kb3gtn/FT2232_JTAG/README.md

# FT2232_JTAG
 FT2232 JTAG/SPI/UART/GPIO board
