kb3gtn/FT2232_JTAG/FT2232_Board.xlsx

item | Description | refdes_list | manufacturer | Manufacturer Part Number | Qty
0 | 0603 3.3uF Capacitor 20% | C1, C2, C4 | Samsung Electro-Mechanics | CL10A335KP8NNNC | 3
1 | 0603 0.1uF Capacitor 20% | C3, C7, C8, C9 | KEMET | 0603C104M5RACAUTO | 4
2 | 0402 18pF Capacitor 20% | C5, C6 | KEMET | C0402C180J5GACAUTO | 2
3 | 0603 LED RED | D1, D2, D3 | Lumex | SML-LXFM0603SRC-TR | 3
4 | 0402 Ferrite Bead 120 Ohm @ 100 MHz | FB1 | Murata Electronics | BLM15AG121SZ1D | 1
5 | USB-C / USB 2.0 connector | J1 | JAE Industry Ltd. | DX07S016JA1R1500 | 1
6 | 100mil header 2x5 | J2, J5 | Amphenol | 77313-822-20LF | 2
7 | 100mil header 2x7 | J3 | Amphenol | 77313-822-20LF | 1
8 | 0603 330 5% Resistor | R1, R4, R5 | YAGEO | AC0603FR-10330RL | 3
9 | 0603 2.2K 5% Resistor | R2 | YAGEO | AC0603FR-102K2L | 1
10 | 0603 12K 1% Resistor | R3 | Vishay / Dale | CRCW060312K0FKEAC | 1
11 | 0603 10K 5% Resistor | R6 | YAGEO | AC0603FR-0710KL | 1
12 | 0603 jumper | R7 | YAGEO | AC0603FR-070RL | 1
13 | 0603 5.1K 5% Resistor | R8, R9 | YAGEO | AC0603FR-135K1L | 2
14 | EEROM 2K | U1 | Microchip | 93LC56BT-I/OT | 1
15 | FT2232HQ USB UART/JTAG/GPIO interface | U2 | FTDI | FT2232HQ | 1
16 | Linear Regulator 1.2A 3.3V | U3 | Diodes Inc. | AZ1117CH-3.3TRG1 | 1
17 | 12 MHz Crystal | Y1 | Abracon | ABM8G-12.000MHZ-18-D2Y-T | 1
