kb3gtn/FT2232_JTAG/93LC56BT-I_OT.STEP

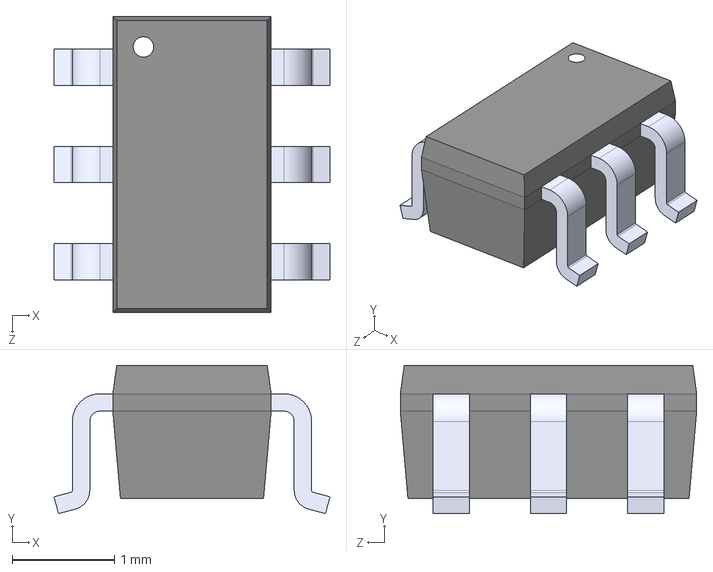
[picture p1: CAD file, 2023-11-22]
93LC56BT-I_OT.STEP
2.70 x 1.45 x 2.90 mm
