kb3gtn/FT2232_JTAG/ABM8G-12.000MHZ-18-D2Y-T/ABM8G-12.000MHZ-18-D2Y-T.step

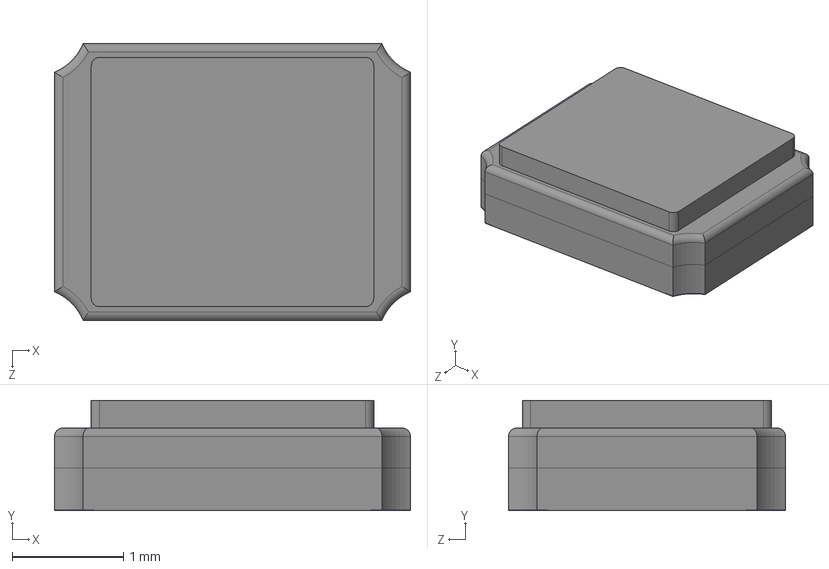
[picture p2: CAD file, 2023-11-22]
ABM8G-12.000MHZ-18-D2Y-T/ABM8G-12.000MHZ-18-D2Y-T.step
3.20 x 0.991 x 2.49 mm
