kb3gtn/FT2232_JTAG/AZ1117CH-3.3TRG1/AZ1117CH-3.3TRG1.step

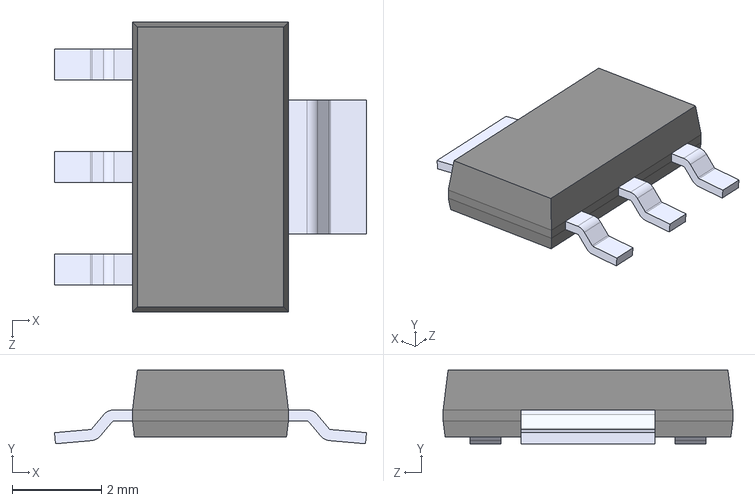
[picture p3: CAD file, 2023-11-22]
AZ1117CH-3.3TRG1/AZ1117CH-3.3TRG1.step
7.00 x 1.65 x 6.50 mm
