kb3gtn/FT2232_JTAG/DX07S016JA1R1500/DX07S016JA1R1500.step

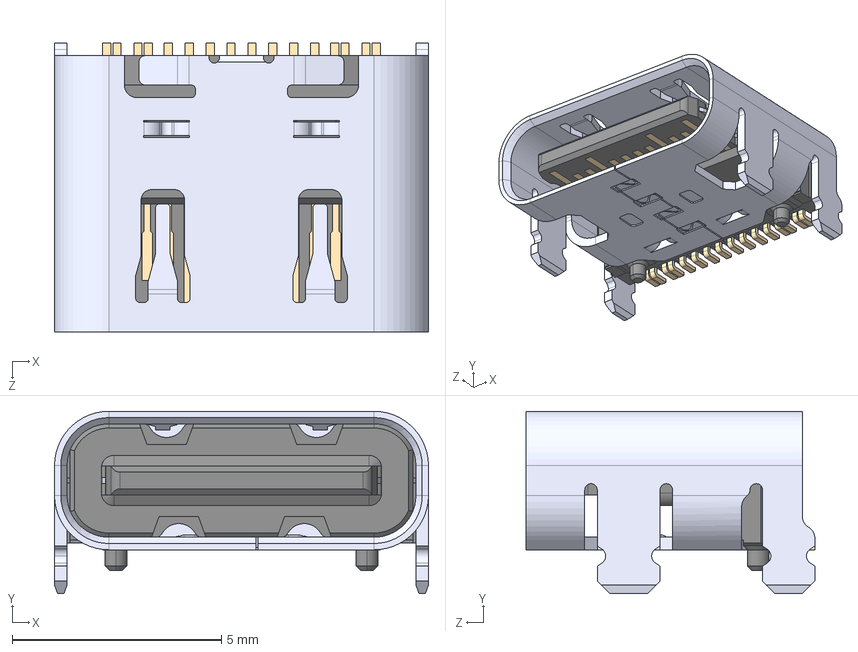
[picture p4: CAD file, 2023-11-22]
DX07S016JA1R1500/DX07S016JA1R1500.step
8.94 x 4.36 x 6.90 mm
