kb3gtn/FT2232_JTAG/Schematic.pdf

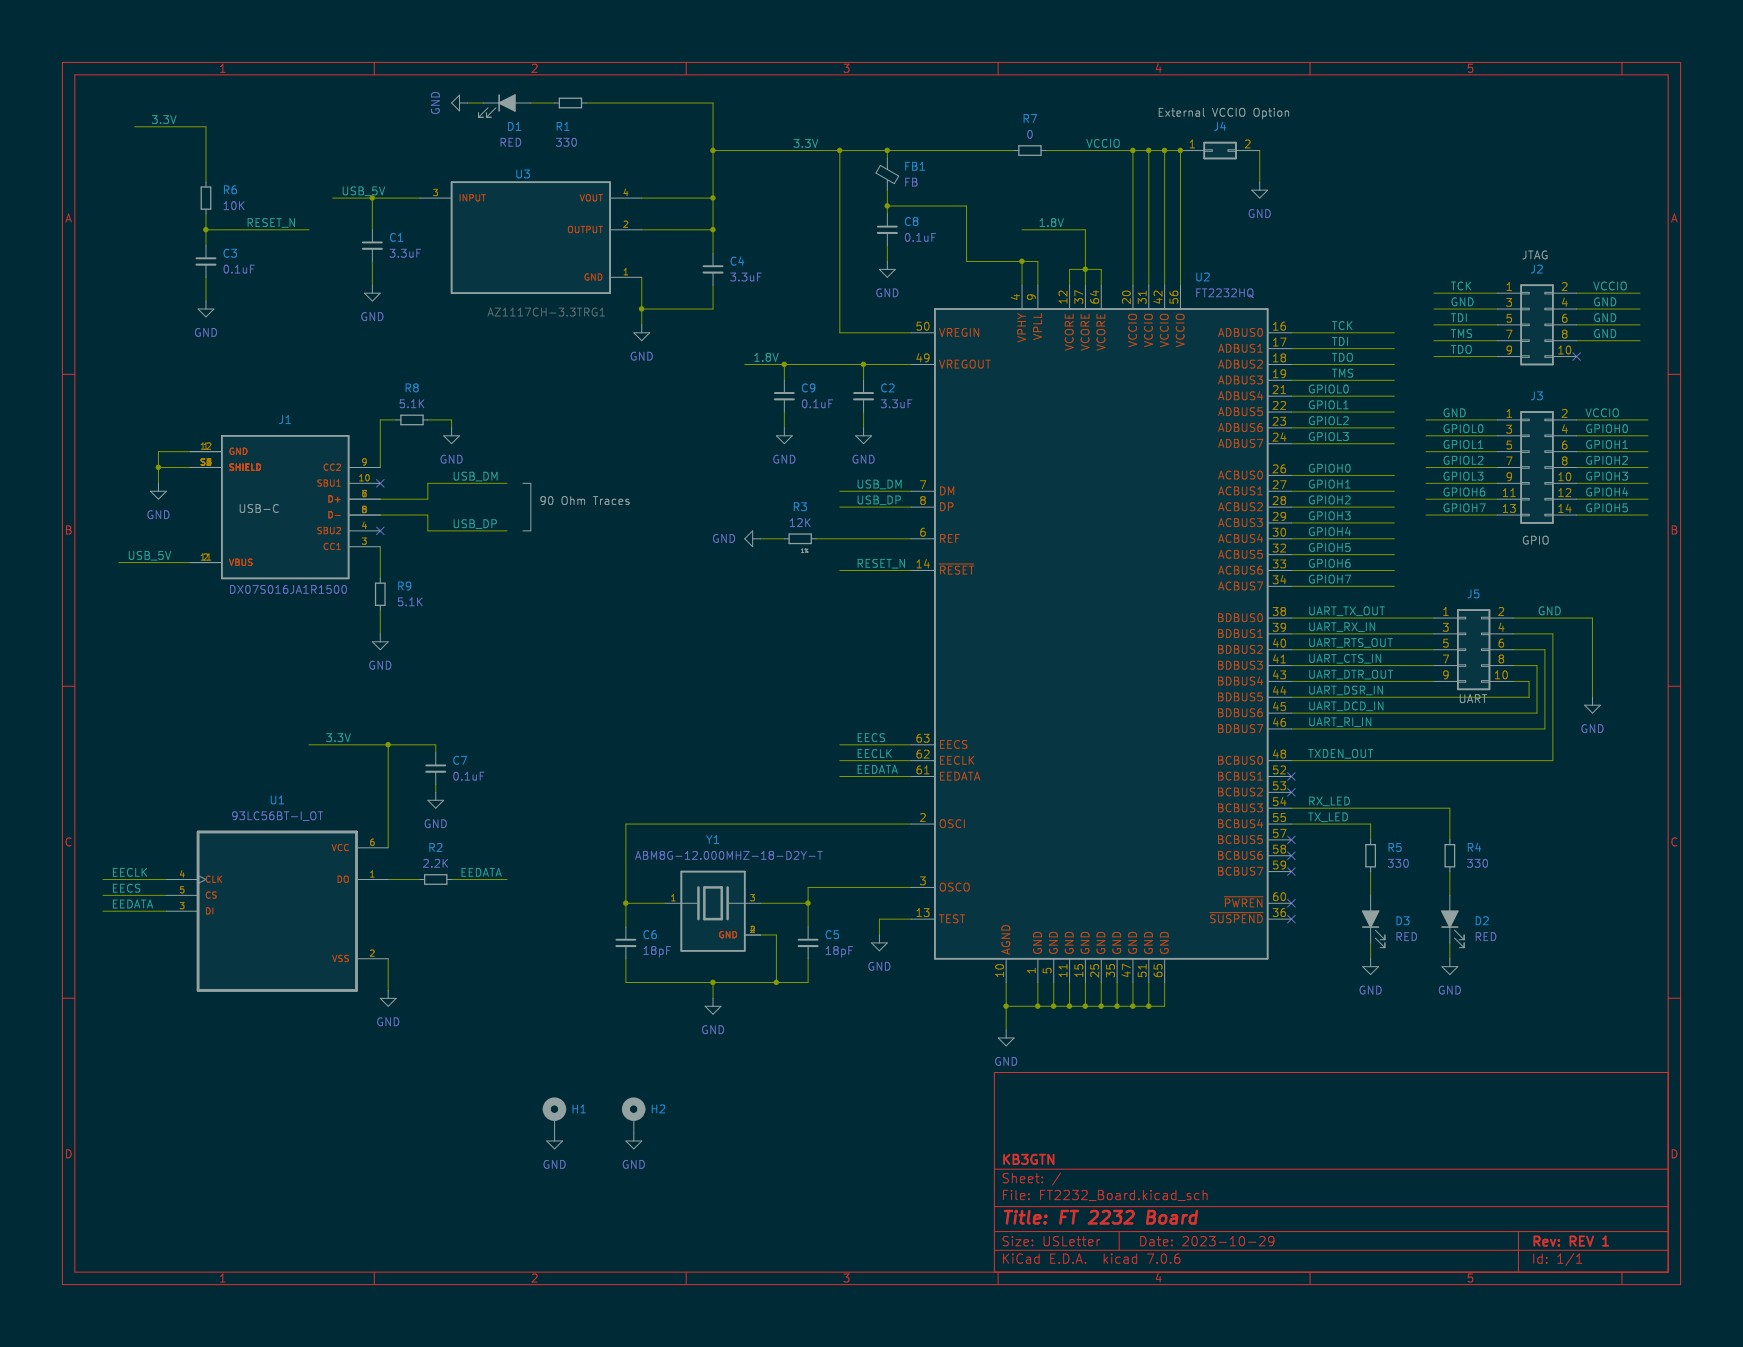
[picture p5: page 1]
