kb3gtn/FT2232_JTAG/FT2232_Board.kicad_pcb

## KiCad design FT2232_Board.kicad_pcb (2023-11-22)

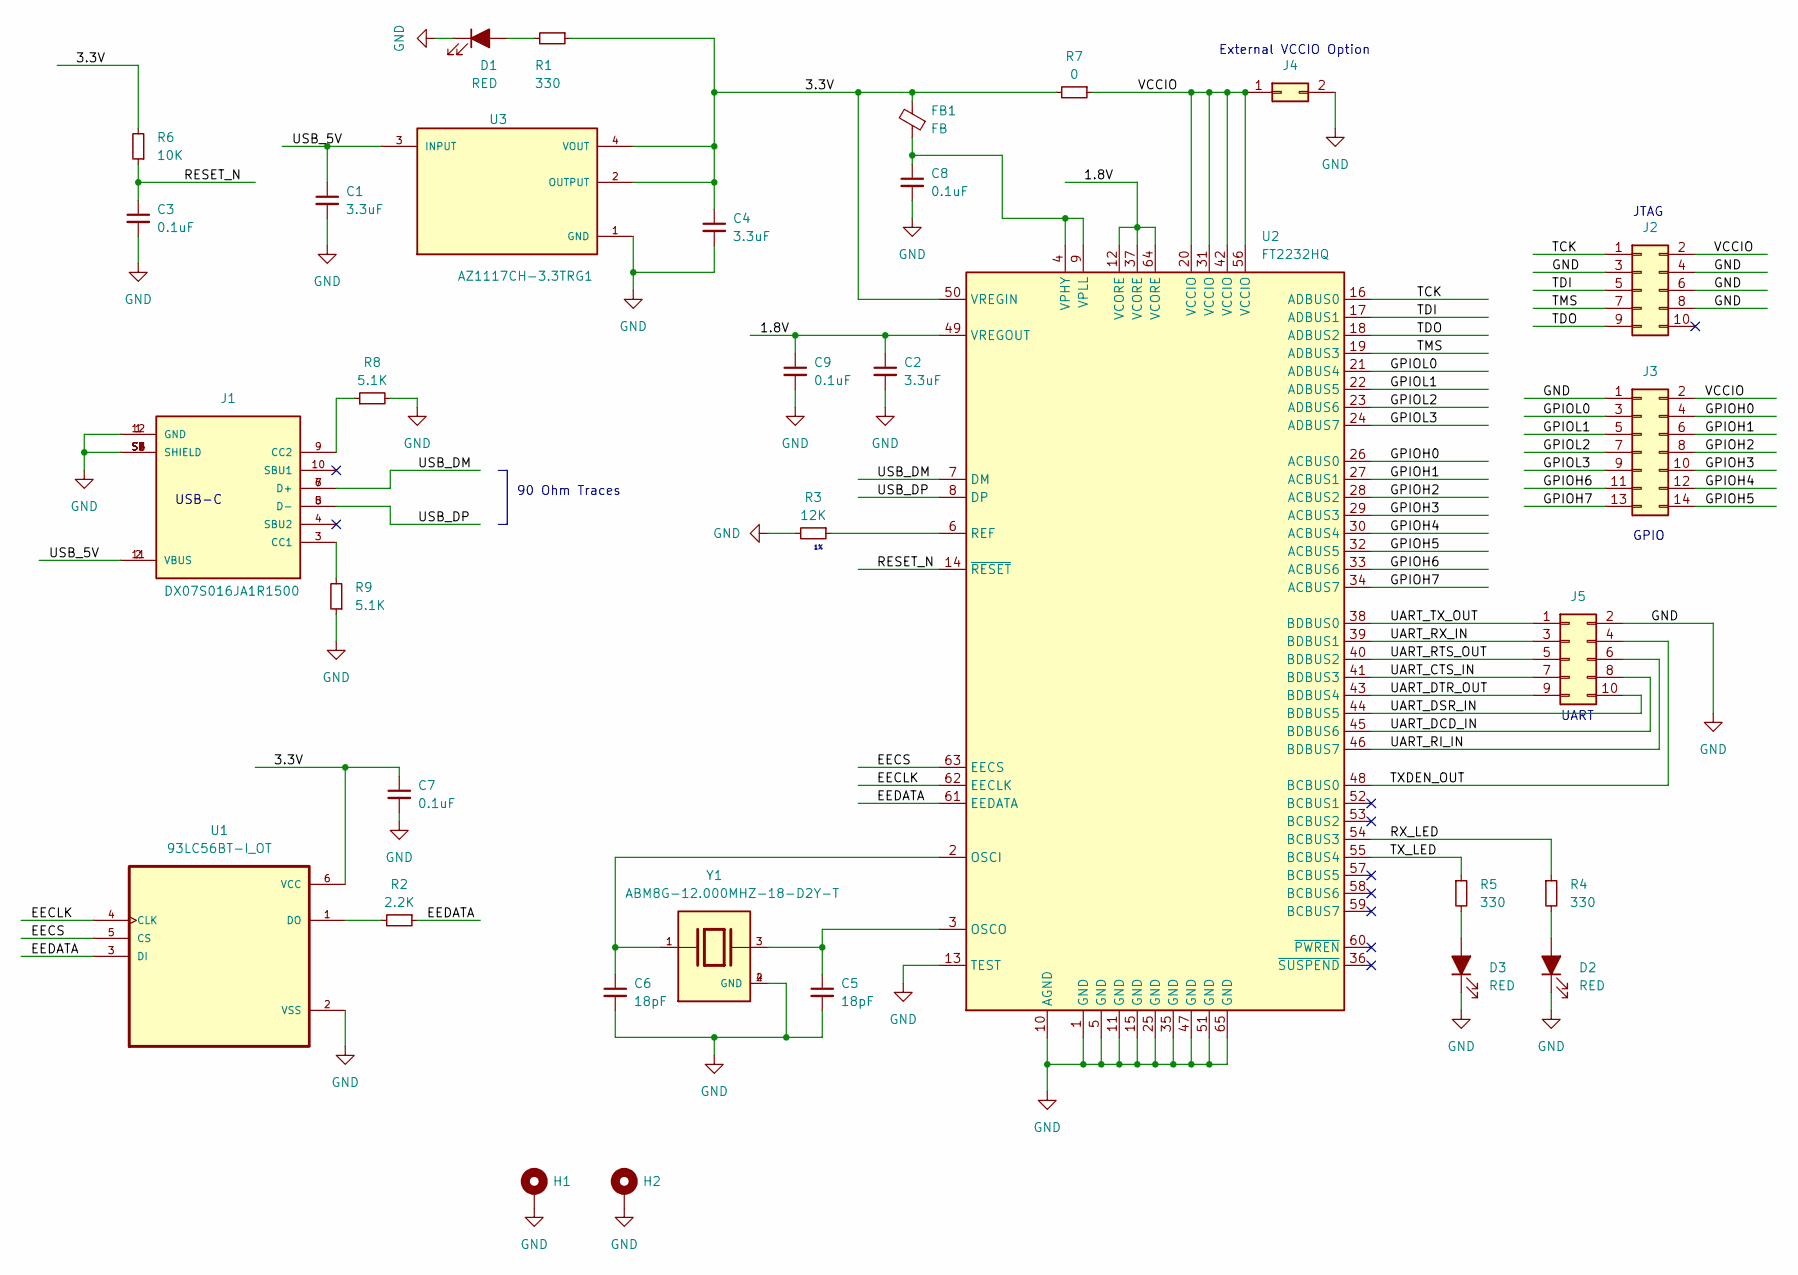
[picture p6: schematic FT2232_Board.kicad_sch, FT 2232 Board]

Parts:
C1, C2, C4: 3.3uF; C_0603_1608Metric_Pad1.08x0.95mm_HandSolder
C3, C7, C8, C9: 0.1uF; C_0603_1608Metric_Pad1.08x0.95mm_HandSolder
C5, C6: 18pF; C_0402_1005Metric_Pad0.74x0.62mm_HandSolder
D1, D2, D3: RED; D_0603_1608Metric_Pad1.05x0.95mm_HandSolder
FB1: FB; R_0402_1005Metric_Pad0.72x0.64mm_HandSolder; Manufacturer Part Number 100 Ohm @ 100 MHz
H1, H2: MountingHole_Pad; MountingHole_2.7mm_M2.5_Pad_Via
J1: DX07S016JA1R1500; JAE_DX07S016JA1R1500; PARTREV 1
J2, J5: Conn_02x05_Odd_Even; PinHeader_2x05_P2.54mm_Vertical; Manufacturer Part Number Generic
J3: Conn_02x07_Odd_Even; PinHeader_2x07_P2.54mm_Vertical; Manufacturer Part Number Generic
J4: Conn_02x01; PinHeader_2x01_P2.54mm_Vertical; Manufacturer Part Number Generic
R1, R4, R5: 330; R_0603_1608Metric_Pad0.98x0.95mm_HandSolder
R2: 2.2K; R_0603_1608Metric_Pad0.98x0.95mm_HandSolder
R3: 12K; R_0603_1608Metric_Pad0.98x0.95mm_HandSolder
R6: 10K; R_0603_1608Metric_Pad0.98x0.95mm_HandSolder
R7: 0; R_0603_1608Metric_Pad0.98x0.95mm_HandSolder
R8, R9: 5.1K; R_0603_1608Metric_Pad0.98x0.95mm_HandSolder
U1: 93LC56BT-I_OT; SOT95P280X145-6N; Manufacturer Part Number 93LC56BT-I/OT
U2: FT2232HQ; QFN-64-1EP_9x9mm_P0.5mm_EP4.35x4.35mm; Manufacturer Part Number FT2232HQ
U3: AZ1117CH-3.3TRG1; DIODES_AZ1117CH-3.3TRG1_0; MOUSER_PART_NUMBER 621-AZ1117CH-3.3TRG1; MOUSER_DESCRIPTION LDO Voltage Regulators LDO BJT HiCurr 1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
Y1: ABM8G-12.000MHZ-18-D2Y-T; XTAL_ABM8G-12.000MHZ-18-D2Y-T; PARTREV 08.13.15

Connections:
/1.8V: C2.1, C9.1, U2.12 (VCORE), U2.37 (VCORE), U2.49 (VREGOUT), U2.64 (VCORE)
/3.3V: C4.1, C7.1, FB1.2, R1.1, R6.2, R7.2, U1.6 (VCC), U2.50 (VREGIN), U3.2 (OUTPUT), U3.4 (VOUT)
/EECLK: U1.4 (CLK), U2.62 (EECLK)
/EECS: U1.5 (CS), U2.63 (EECS)
/EEDATA: R2.1, U1.3 (DI), U2.61 (EEDATA)
/GPIOH0: J3.4, U2.26 (ACBUS0)
/GPIOH1: J3.6, U2.27 (ACBUS1)
/GPIOH2: J3.8, U2.28 (ACBUS2)
/GPIOH3: J3.10, U2.29 (ACBUS3)
/GPIOH4: J3.12, U2.30 (ACBUS4)
/GPIOH5: J3.14, U2.32 (ACBUS5)
/GPIOH6: J3.11, U2.33 (ACBUS6)
/GPIOH7: J3.13, U2.34 (ACBUS7)
/GPIOL0: J3.3, U2.21 (ADBUS4)
/GPIOL1: J3.5, U2.22 (ADBUS5)
/GPIOL2: J3.7, U2.23 (ADBUS6)
/GPIOL3: J3.9, U2.24 (ADBUS7)
/RESET_N: C3.1, R6.1, U2.14 (~RESET)
/RX_LED: R4.1, U2.54 (BCBUS3)
/TCK: J2.1, U2.16 (ADBUS0)
/TDI: J2.5, U2.17 (ADBUS1)
/TDO: J2.9, U2.18 (ADBUS2)
/TMS: J2.7, U2.19 (ADBUS3)
/TXDEN_OUT: J5.4, U2.48 (BCBUS0)
/TX_LED: R5.1, U2.55 (BCBUS4)
/UART_CTS_IN: J5.7, U2.41 (BDBUS3)
/UART_DCD_IN: J5.8, U2.45 (BDBUS6)
/UART_DSR_IN: J5.10, U2.44 (BDBUS5)
/UART_DTR_OUT: J5.9, U2.43 (BDBUS4)
/UART_RI_IN: J5.6, U2.46 (BDBUS7)
/UART_RTS_OUT: J5.5, U2.40 (BDBUS2)
/UART_RX_IN: J5.3, U2.39 (BDBUS1)
/UART_TX_OUT: J5.1, U2.38 (BDBUS0)
/USB_5V: C1.1, J1.2 (VBUS), J1.11 (VBUS), U3.3 (INPUT)
/USB_DM: J1.6 (D+), J1.7 (D+), U2.7 (DM)
/USB_DP: J1.5 (D-), J1.8 (D-), U2.8 (DP)
/VCCIO: J2.2, J3.2, J4.1, R7.1, U2.20 (VCCIO), U2.31 (VCCIO), U2.42 (VCCIO), U2.56 (VCCIO)
GND: C1.2, C2.2, C3.2, C4.2, C5.2, C6.2, C7.2, C8.2, C9.2, D1.1 (K), D2.1 (K), D3.1 (K), H1.1, H2.1, J1.1 (GND), J1.12 (GND), J1.S1 (SHIELD), J1.S2 (SHIELD), J1.S3 (SHIELD), J1.S4 (SHIELD), J1.S5 (SHIELD), J1.S6 (SHIELD), J2.3, J2.4, J2.6, J2.8, J3.1, J4.2, J5.2, R3.2, R8.2, R9.1, U1.2 (VSS), U2.1 (GND), U2.5 (GND), U2.10 (AGND), U2.11 (GND), U2.13 (TEST), U2.15 (GND), U2.25 (GND), U2.35 (GND), U2.47 (GND), U2.51 (GND), U2.65 (GND), U3.1 (GND), Y1.2 (GND), Y1.4 (GND)
unnamed: D3.2 (A), R5.2
unnamed: D2.2 (A), R4.2
unnamed: D1.2 (A), R1.2
unnamed: J1.3 (CC1), R9.2
unnamed: J1.9 (CC2), R8.1
unnamed: C6.1, U2.2 (OSCI), Y1.1
unnamed: C5.1, U2.3 (OSCO), Y1.3
unnamed: R3.1, U2.6 (REF)
unnamed: C8.1, FB1.1, U2.4 (VPHY), U2.9 (VPLL)
unnamed: R2.2, U1.1 (DO)

Notes on the sheet:
JTAG
90 Ohm Traces
UART
External VCCIO Option
GPIO
USB-C

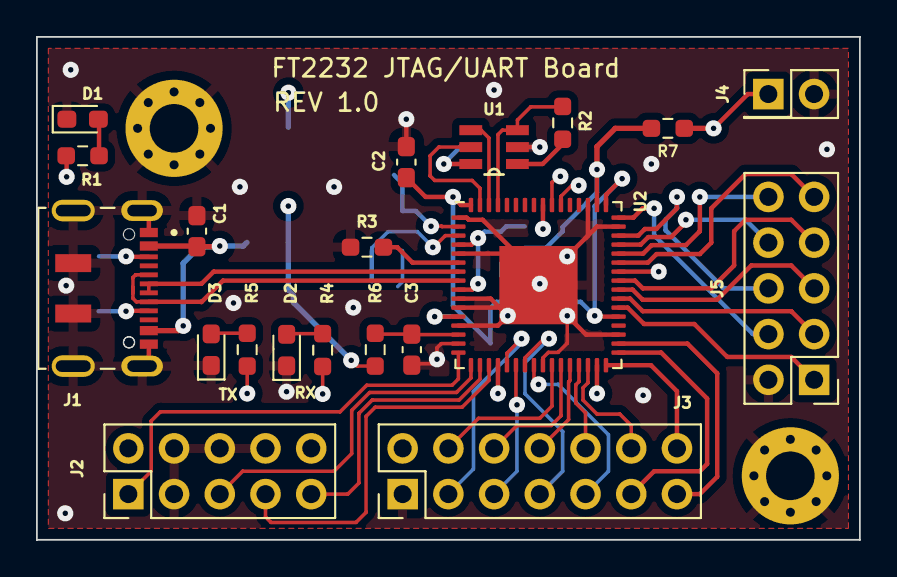
[picture p7: board FT2232_Board.kicad_pcb from above]

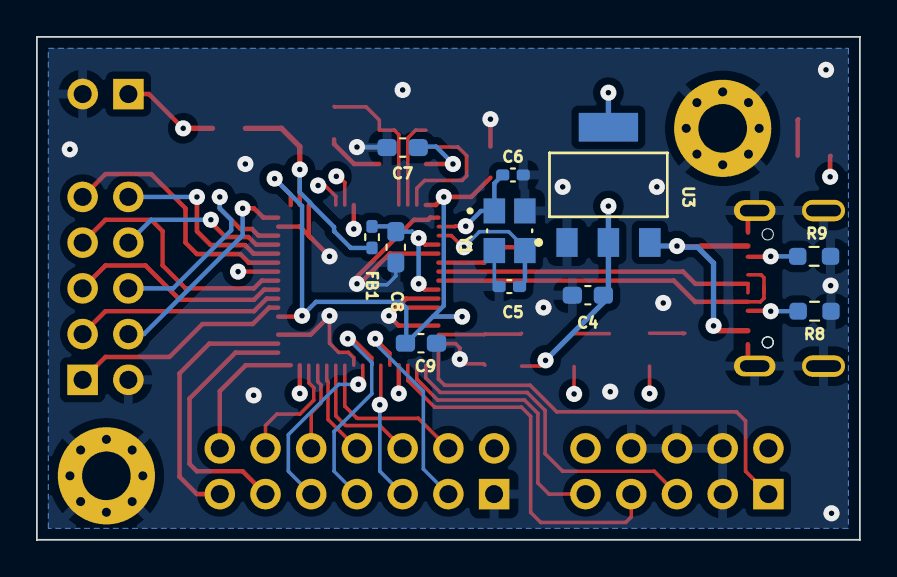
[picture p8: board FT2232_Board.kicad_pcb from below]

Board: 4 copper layers, 45.7 x 27.9 mm, 33 parts (11 on the bottom side), 48 nets.
