kb3gtn/FT2232_JTAG/(commit log)

2023-11-22 Initial Checkin
    Initial Checkin
    [93LC56BT-I_OT.STEP, 93LC56BT-I_OT.step, ABM8G-12.000MHZ-18-D2Y-T.step, AZ1117CH-3.3TRG1.step, DX07S016JA1R1500.step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]
2023-11-22 Added pdf schematic
    added PDF schematic
